wilber111978-sketch/Balboa-Spa-retrofit-esp32/docs/FIRMWARE_STRUCTURE.md

# Firmware Structure

Recommended project layout:

```
firmware/
  src/
    main.cpp
    config.h

    control/
      spa_state_machine.cpp
      spa_state_machine.h
      heater_control.cpp
      heater_control.h
      pump_control.cpp
      pump_control.h
      safety_manager.cpp
      safety_manager.h

    sensors/
      heater_sensors.cpp
      heater_sensors.h
      current_monitor.cpp
      current_monitor.h

    topside/
      gc9a01_display.cpp
      gc9a01_display.h
      topside_buttons.cpp
      topside_buttons.h
      topside_ui.cpp
      topside_ui.h

    diagnostics/
      fault_manager.cpp
      fault_manager.h
      fault_catalog.cpp
      fault_catalog.h
      event_log.cpp
      event_log.h

    web/
      web_server.cpp
      web_server.h
      api.cpp
      api.h

    matter/
      matter_bridge.cpp
      matter_bridge.h

    storage/
      settings.cpp
      settings.h

  data/
    index.html
    app.js
    styles.css

  test/
    test_state_machine.cpp
    test_fault_logic.cpp
    test_sensor_validation.cpp
    test_topside_buttons.cpp
    test_topside_ui.cpp
```

## Architectural rules

### Safety first
All hardware outputs are controlled through one safety-aware state machine.

No web / Matter / TFT/button handler may directly energize:
- heater SSR
- heater safety contactor
- pump contactors

Interfaces submit requests to the controller.

### New topside
The old VL260 protocol decoder is no longer part of the production firmware.

The replacement local UI is:
- GC9A01 240×240 TFT
- Jets button
- Light button
- Temperature + button
- Temperature - button

Button handling must include:
- debounce
- stuck-button detection
- optional long-press behavior
- no blocking delays

The display renders controller state only; it is not the source of truth.

### Single source of truth
Maintain one central spa state model containing:
- current mode
- target temperature
- measured temperatures
- pump state
- heater state
- light state
- UV state
- fault state
- safety permissives

### Fault manager
Responsible for:
- creating fault events
- assigning concise local display codes/titles
- storing probable causes
- storing recommended checks
- retry / latch policy

### Event log
Use a compact ring-buffer / persistent log for:
- faults
- major state transitions
- heater cycles
- manual resets
- controller reboots

### Matter
Matter exposes only safe high-level controls:
- setpoint
- jets
- light
- basic status

### Web UI
The web UI exposes deeper diagnostics but routes all commands through the same safety layer.

### Testing
State-machine, topside-button and fault logic should be unit-tested before mains commissioning.
