wilber111978-sketch/Balboa-Spa-retrofit-esp32/docs/MASTER_GPIO_MAP.md

# Master GPIO / I/O Allocation

This is the project-wide source of truth for ESP32-S3 pin usage. Update this file whenever a GPIO is reassigned.

## Onboard fixed functions — Waveshare ESP32-S3 Relay 6CH

| GPIO | Function | Status |
|---:|---|---|
| GPIO1 | Relay CH1 | USED |
| GPIO2 | Relay CH2 | USED |
| GPIO41 | Relay CH3 | USED |
| GPIO42 | Relay CH4 | USED |
| GPIO45 | Relay CH5 | USED |
| GPIO46 | Relay CH6 | USED |
| GPIO17 | RS485 TX | RESERVED |
| GPIO18 | RS485 RX | RESERVED |
| GPIO21 | Buzzer | RESERVED |
| GPIO38 | RGB LED | RESERVED |
| GPIO0 | BOOT | RESERVED |

## Project assignments

### Sensor bus

| GPIO | Project use | Status |
|---:|---|---|
| GPIO8 | I2C SDA — ADS1115 / sensor expansion | ASSIGNED |
| GPIO9 | I2C SCL — ADS1115 / sensor expansion | ASSIGNED |

### Replacement topside — GC9A01 1.28-inch 240×240 TFT

| GPIO | TFT function | Status |
|---:|---|---|
| GPIO10 | SPI SCLK | ASSIGNED |
| GPIO11 | SPI MOSI / DIN | ASSIGNED |
| GPIO12 | TFT CS | ASSIGNED |
| GPIO13 | TFT DC | ASSIGNED |
| GPIO14 | TFT RESET | ASSIGNED |
| GPIO15 | TFT backlight control | ASSIGNED |

TFT supply:
- VCC: 3.3 V
- GND: GND

### Waterproof momentary buttons

| GPIO | Button | Status |
|---:|---|---|
| GPIO4 | Jets | ASSIGNED |
| GPIO5 | Light | ASSIGNED |
| GPIO6 | Temperature + | ASSIGNED |
| GPIO7 | Temperature - | ASSIGNED |

Buttons should be wired as simple momentary digital inputs using a defined pull-up/pull-down strategy, with software debounce and stuck-button detection.

### Heater SSR

| GPIO | Function | Status |
|---:|---|---|
| GPIO16 | heater SSR MOSFET driver | ASSIGNED |

## Relay channel allocation

| Relay | GPIO | Function |
|---|---:|---|
| CH1 | GPIO1 | Pump LOW contactor |
| CH2 | GPIO2 | Pump HIGH contactor |
| CH3 | GPIO41 | Heater safety contactor |
| CH4 | GPIO42 | UV / ozone |
| CH5 | GPIO45 | Spa light |
| CH6 | GPIO46 | Spare / future |

## Currently free / candidate GPIOs

The following exposed pins are currently unassigned and may be used later after bench verification:

- GPIO3
- GPIO35
- GPIO36
- GPIO37
- GPIO39
- GPIO40
- GPIO47
- GPIO48

Do not allocate any permanently without checking:
- Waveshare schematic
- boot/strap behavior
- onboard peripheral conflicts
- voltage compatibility

## Rules

1. No user-interface code may directly control mains outputs.
2. Matter, web UI and topside button handlers only submit requests to the safety state machine.
3. GPIO assignments in firmware must be defined in one central config file.
4. Any pin change must be reflected here before firmware is merged.
5. The old VL260 RJ45/data/clock/button-emulation GPIO allocation is retired.
