wilber111978-sketch/Balboa-Spa-retrofit-esp32/docs/HARDWARE_INVENTORY.md

# Hardware Inventory — Master

## Arrived / physically in hand

- Waveshare ESP32-S3 Relay-6CH
- 24 VDC DIN power supply, MDR-60-24 style, 60 W / 2.5 A
- 2 x CJX2-K1201 DC pump contactors
- JOTTA SSR-40DA zero-cross SSR
- SSR aluminium heatsink
- ferrule assortment
- ferrule crimping tools
- modular/RJ-style breakout / termination adapter for low-voltage panel work
- Molex spa harness connector parts / crimp contacts as ordered

## Ordered / pending or to confirm

- heater safety contactor, 24 VDC, 25 A, 2NO
- waterproof enclosure
- independent heater high-limit device
- DIN terminal/distribution blocks
- coil suppressors
- MVP260 interface components
- ADS1115 module
- 4-channel optocoupler module
- low-side MOSFET module for SSR drive (existing farm-sensor spare may be reused after verification)

## Bench-layout note

Enclosure size will be selected only after all major hardware is laid out on DIN rail with:
- cable bend radius
- SSR heatsink clearance
- mains / low-voltage separation
- terminal blocks
- service loops
- future expansion margin
