wilber111978-sketch/Balboa-Spa-retrofit-esp32/docs/BOM.md

# Bill of Materials

## Ordered / selected

| Qty | Part | Notes |
|---:|---|---|
| 1 | Waveshare ESP32-S3 6CH industrial relay module | Main controller |
| 1 | 24 VDC DIN PSU, 60 W / 2.5 A | Control supply |
| 2 | CJX2-K1201 DC, 24 VDC | 12 A AC-3 pump contactors, 3NO + 1NC |
| 1 | JOTTA SSR-40DA or equivalent | 40 A nominal, zero-cross heater SSR |
| 2 | Molex 50-84-2042 | 4-position female cable housing |
| 1 | Molex 50-84-2032 | 3-position female cable housing |
| 1 | Molex 50-84-2022 | 2-position female cable housing |
| 20 | Molex 02-08-1002 | female crimp contacts |
| assorted | Ferrules | 0.5 / 0.75 / 1.0 / 1.5 / 2.5 mm² |

## Still to finalize / purchase

| Qty | Item | Notes |
|---:|---|---|
| 1 | Waterproof enclosure | size after bench layout |
| 1 | Heater safety contactor | 2-pole, 20–25 A AC-1 or better, 24 VDC coil |
| 1 | Independent heater high-limit | manual reset preferred |
| 1 | SSR heatsink | sized for continuous ~8.3 A heater load |
| 1 | Thermal compound | SSR to heatsink |
| 2–3 | 24 V coil suppressors | pump contactors + heater safety contactor |
| assorted | DIN rail | 35 mm |
| assorted | DIN terminal blocks | active / neutral / PE / 24 V / 0 V |
| 1 | Earth bar / PE distribution | |
| 1 | Neutral distribution block | |
| 1 | Active distribution block | finger-safe |
| assorted | branch protection | small breaker / fuse for control circuits |
| assorted | IP-rated cable glands | |
| assorted | internal mains wire | final gauge to suit circuit and terminals |
| assorted | 24 V control wire | |
| 1 set | MVP260 interface parts | based on open-source Balboa interface work |
| optional | pump current sensor | enhanced diagnostics |
| optional | heater current sensor | enhanced diagnostics |
| optional | SSR temperature sensor | enhanced diagnostics |

## Future chemistry

- isolated pH interface
- isolated ORP interface
- pH probe
- ORP probe
- sample flow cell
- dosing pump(s)
- chemical tank level sensing
