wilber111978-sketch/Balboa-Spa-retrofit-esp32/(commit log)

2026-09-25 Add initial bill of materials
2026-09-25 Add harness and pin mapping plan
2026-09-25 Add heater M7 state machine specification
2026-09-25 Add OEM M7 sensor electrical interface and resistance table
2026-09-25 Add V1 hardware interface schematic
2026-11-10 Replace VL260 interface with TFT and button wiring
